mkirkhart/Tracksoar_Hardware/Tracksoar/Tracksoar-Thermistor-Buzzer-Shield.brd

## EAGLE design Tracksoar/Tracksoar-Thermistor-Buzzer-Shield.brd (2017-05-14)

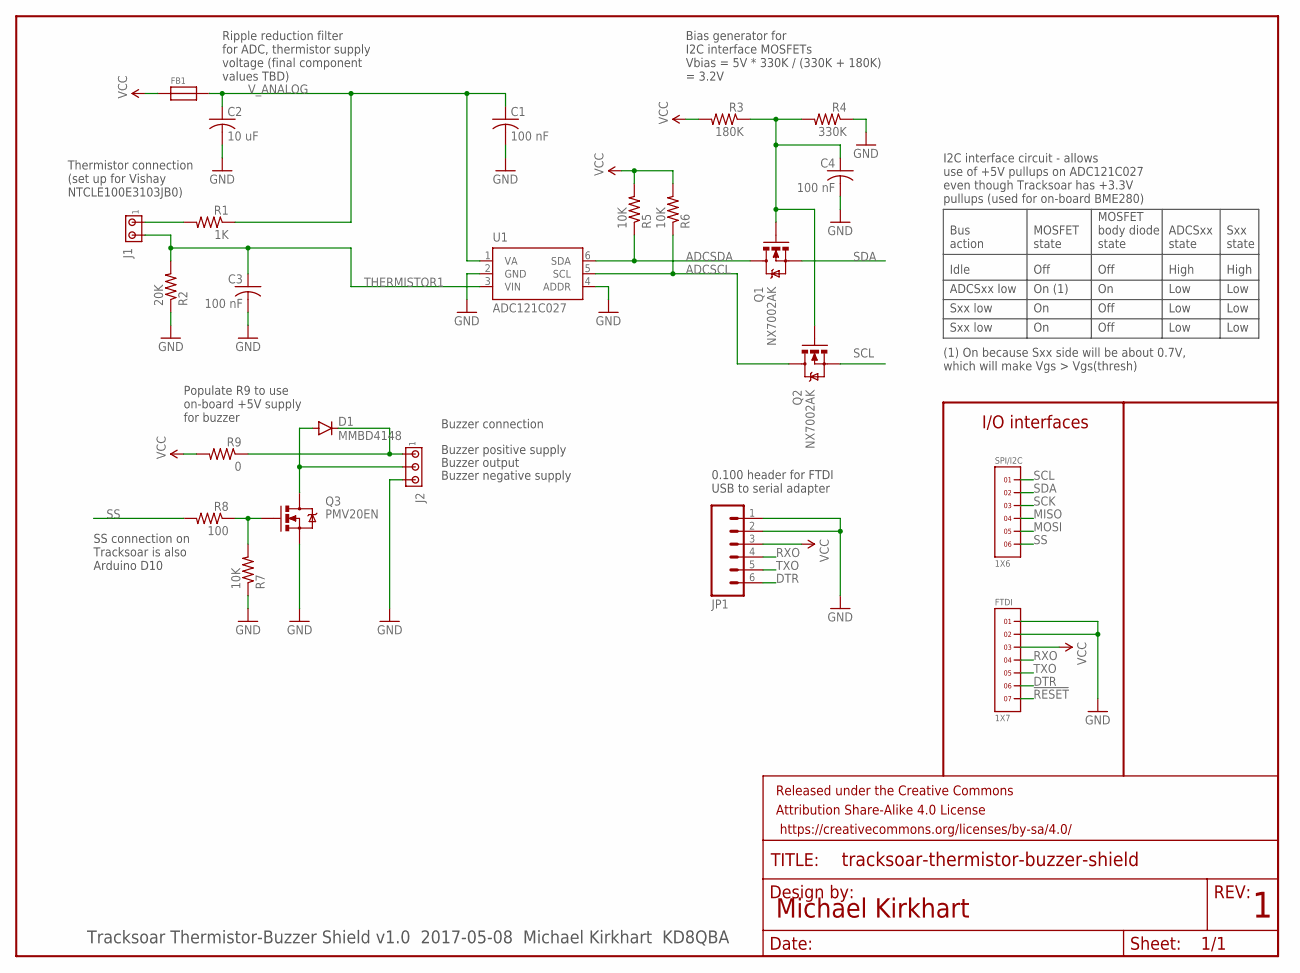
[picture p1: schematic Tracksoar-Thermistor-Buzzer-Shield.sch]

Parts:
C1, C3, C4: 100 nF; C0805
C2: 10 uF; C0805
D1: MMBD4148; SOT23-3
FB1: FERRITE0805; 0805
FRAME1: FRAME-LETTER; CREATIVE_COMMONS
FTDI: 1X7
J1: MTA02-100; 10X02MTA
J2: MTA03-100; 10X03MTA
JP1: M06SILK_FEMALE_PTH; 1X06
Q1, Q2: NX7002AK; SOT23-3
Q3: PMV20EN; SOT23-3
R1: 1K; R0805
R2: 20K; R0805
R3: 180K; R0805
R4: 330K; R0805
R5, R6, R7: 10K; R0805
R8: 100; R0805
R9: 0; R0805
SPI/I2C: 1X6
U1: ADC121C027; SOT23-6

Connections:
!RESET: FTDI.7
ADCSCL: Q2.3 (D), R6.1, U1.5 (SCL)
ADCSDA: Q1.3 (D), R5.1, U1.6 (SDA)
DTR: FTDI.6, JP1.6
GND: C1.2, C2.2, C3.2, C4.2, FTDI.1, FTDI.2, J2.3, JP1.1, JP1.2, Q3.2 (S), R2.1, R4.1, R7.1, U1.2 (GND), U1.4 (ADDR)
MISO: SPI/I2C.4
MOSI: SPI/I2C.5
unnamed: C4.1, Q1.1 (G), Q2.1 (G), R3.1, R4.2
unnamed: Q3.1 (G), R7.2, R8.1
unnamed: J1.1, R1.2
unnamed: D1.1 (A), J2.2, Q3.3 (D)
unnamed: D1.3 (C), J2.1, R9.1
RXO: FTDI.4, JP1.4
SCK: SPI/I2C.3
SCL: Q2.2 (S), SPI/I2C.1
SDA: Q1.2 (S), SPI/I2C.2
SS: R8.2, SPI/I2C.6
THERMISTOR1: C3.1, J1.2, R2.2, U1.3 (VIN)
TXO: FTDI.5, JP1.5
VCC: FB1.1, FTDI.3, JP1.3, R3.2, R5.2, R6.2, R9.2
V_ANALOG: C1.1, C2.1, FB1.2, R1.1, U1.1 (VA)

Notes on the sheet:
Michael Kirkhart
I/O interfaces
Tracksoar Thermistor-Buzzer Shield v1.0 2017-05-08 Michael Kirkhart KD8QBA
Buzzer positive supply
Buzzer output
Buzzer negative supply
0.100 header for FTDI USB to serial adapter
Thermistor connection (set up for Vishay NTCLE100E3103JB0)
Buzzer connection
SS connection on Tracksoar is also Arduino D10
Bias generator for I2C interface MOSFETs Vbias = 5V * 330K / (330K + 180K) = 3.2V
I2C interface circuit - allows use of +5V pullups on ADC121C027 even though Tracksoar has +3.3V pullups (used for on-board BME280)
MOSFET state
Sxx state
MOSFET body diode state
Idle
ADCSxx low
Sxx low
Off
Bus action
ADCSxx state
On (1)
High
Low
(1) On because Sxx side will be about 0.7V, which will make Vgs > Vgs(thresh)
Ripple reduction filter for ADC, thermistor supply voltage (final component values TBD)
Populate R9 to use on-board +5V supply for buzzer

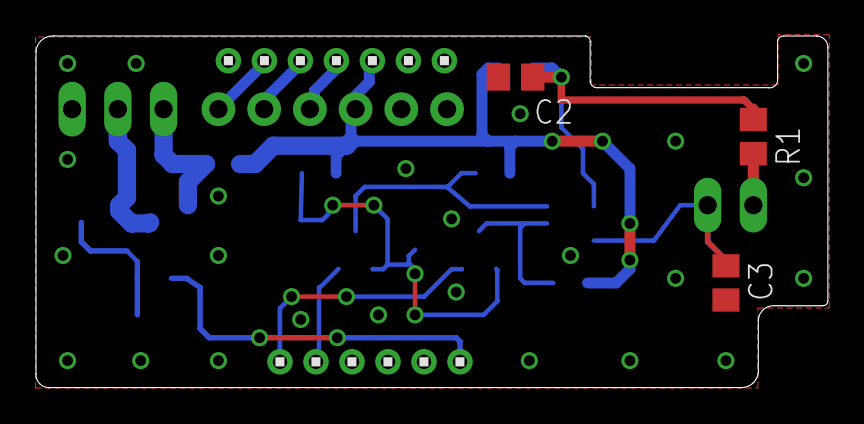
[picture p2: board Tracksoar-Thermistor-Buzzer-Shield.brd from above]

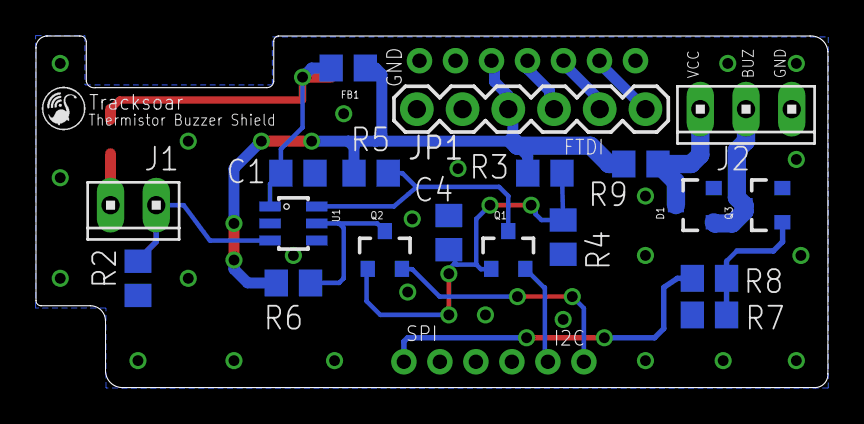
[picture p3: board Tracksoar-Thermistor-Buzzer-Shield.brd from below]

Board: 2 copper layers, 44.0 x 19.5 mm, 25 parts (19 on the bottom side), 17 nets.
